rothman5/eighty-percent/README.md

# Mech-Eighty v1.0
A simple 87% mechanical keyboard for hobbyists. The system is implemented using an STM32 microcontroller.
This project was used to help me learn about microcontrollers, signal integrity and manufacturing.

## Features
- Uses my external [daughter board](https://github.com/rothman5/usbc-daughter-board) for USB.
- (TODO) QMK and VIA firmware support.
- (TODO) Gasket mount using poron foam gaskets.
- (TODO) Wooden, two-piece, CNC machined case.

## Photos
(TODO)

## References
- ST's [AN2586](https://www.st.com/resource/en/application_note/an2586-getting-started-with-stm32f10xxx-hardware-development-stmicroelectronics.pdf) hardware development article
- ST's [AN2867](https://www.st.com/resource/en/application_note/cd00221665-oscillator-design-guide-for-stm8afals-stm32-mcus-and-mpus-stmicroelectronics.pdf) oscillator design article
