rothman5/eighty-percent/images/keyboard-layout.png

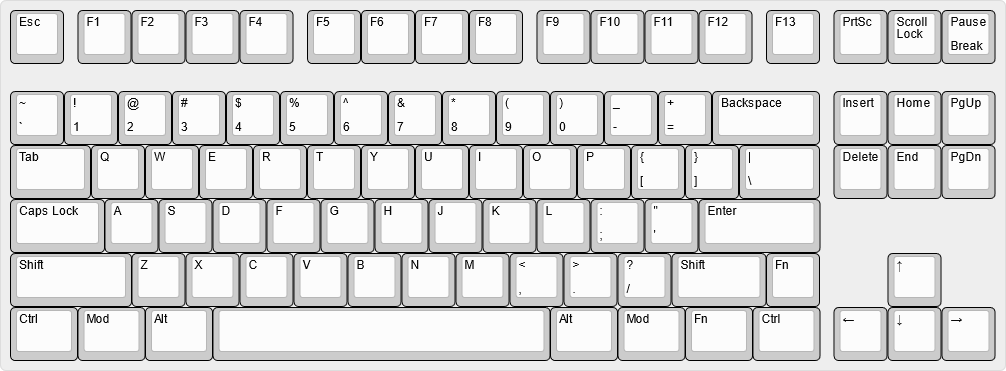
images/keyboard-layout.png
