rothman5/eighty-percent/images/pcb_back.pdf

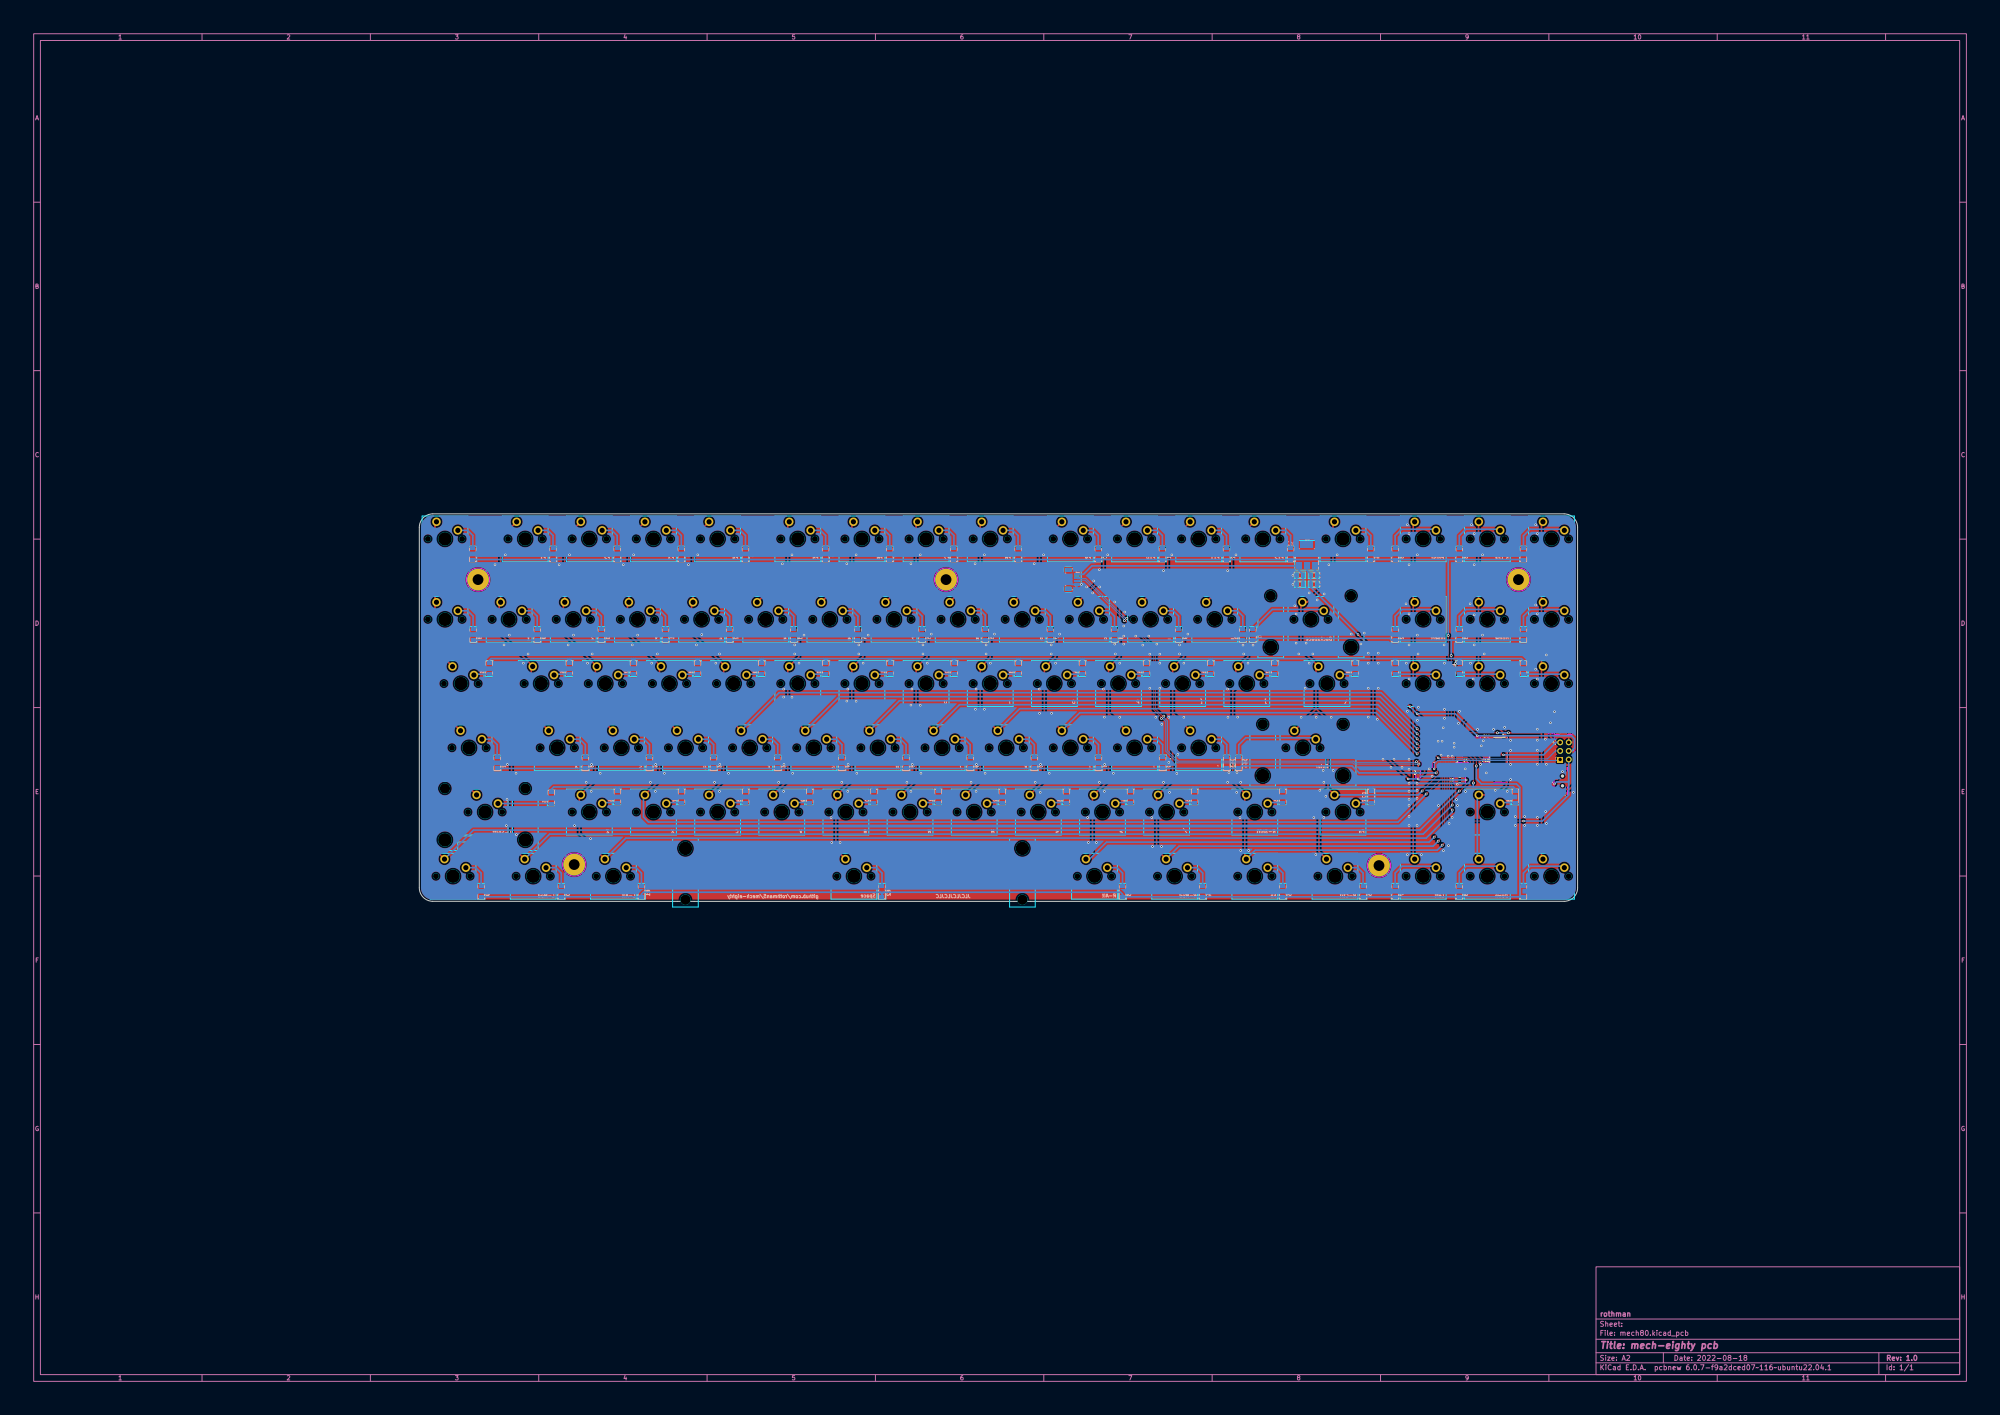
[picture p4: page 1]
