rothman5/eighty-percent/images/pcb_front.pdf

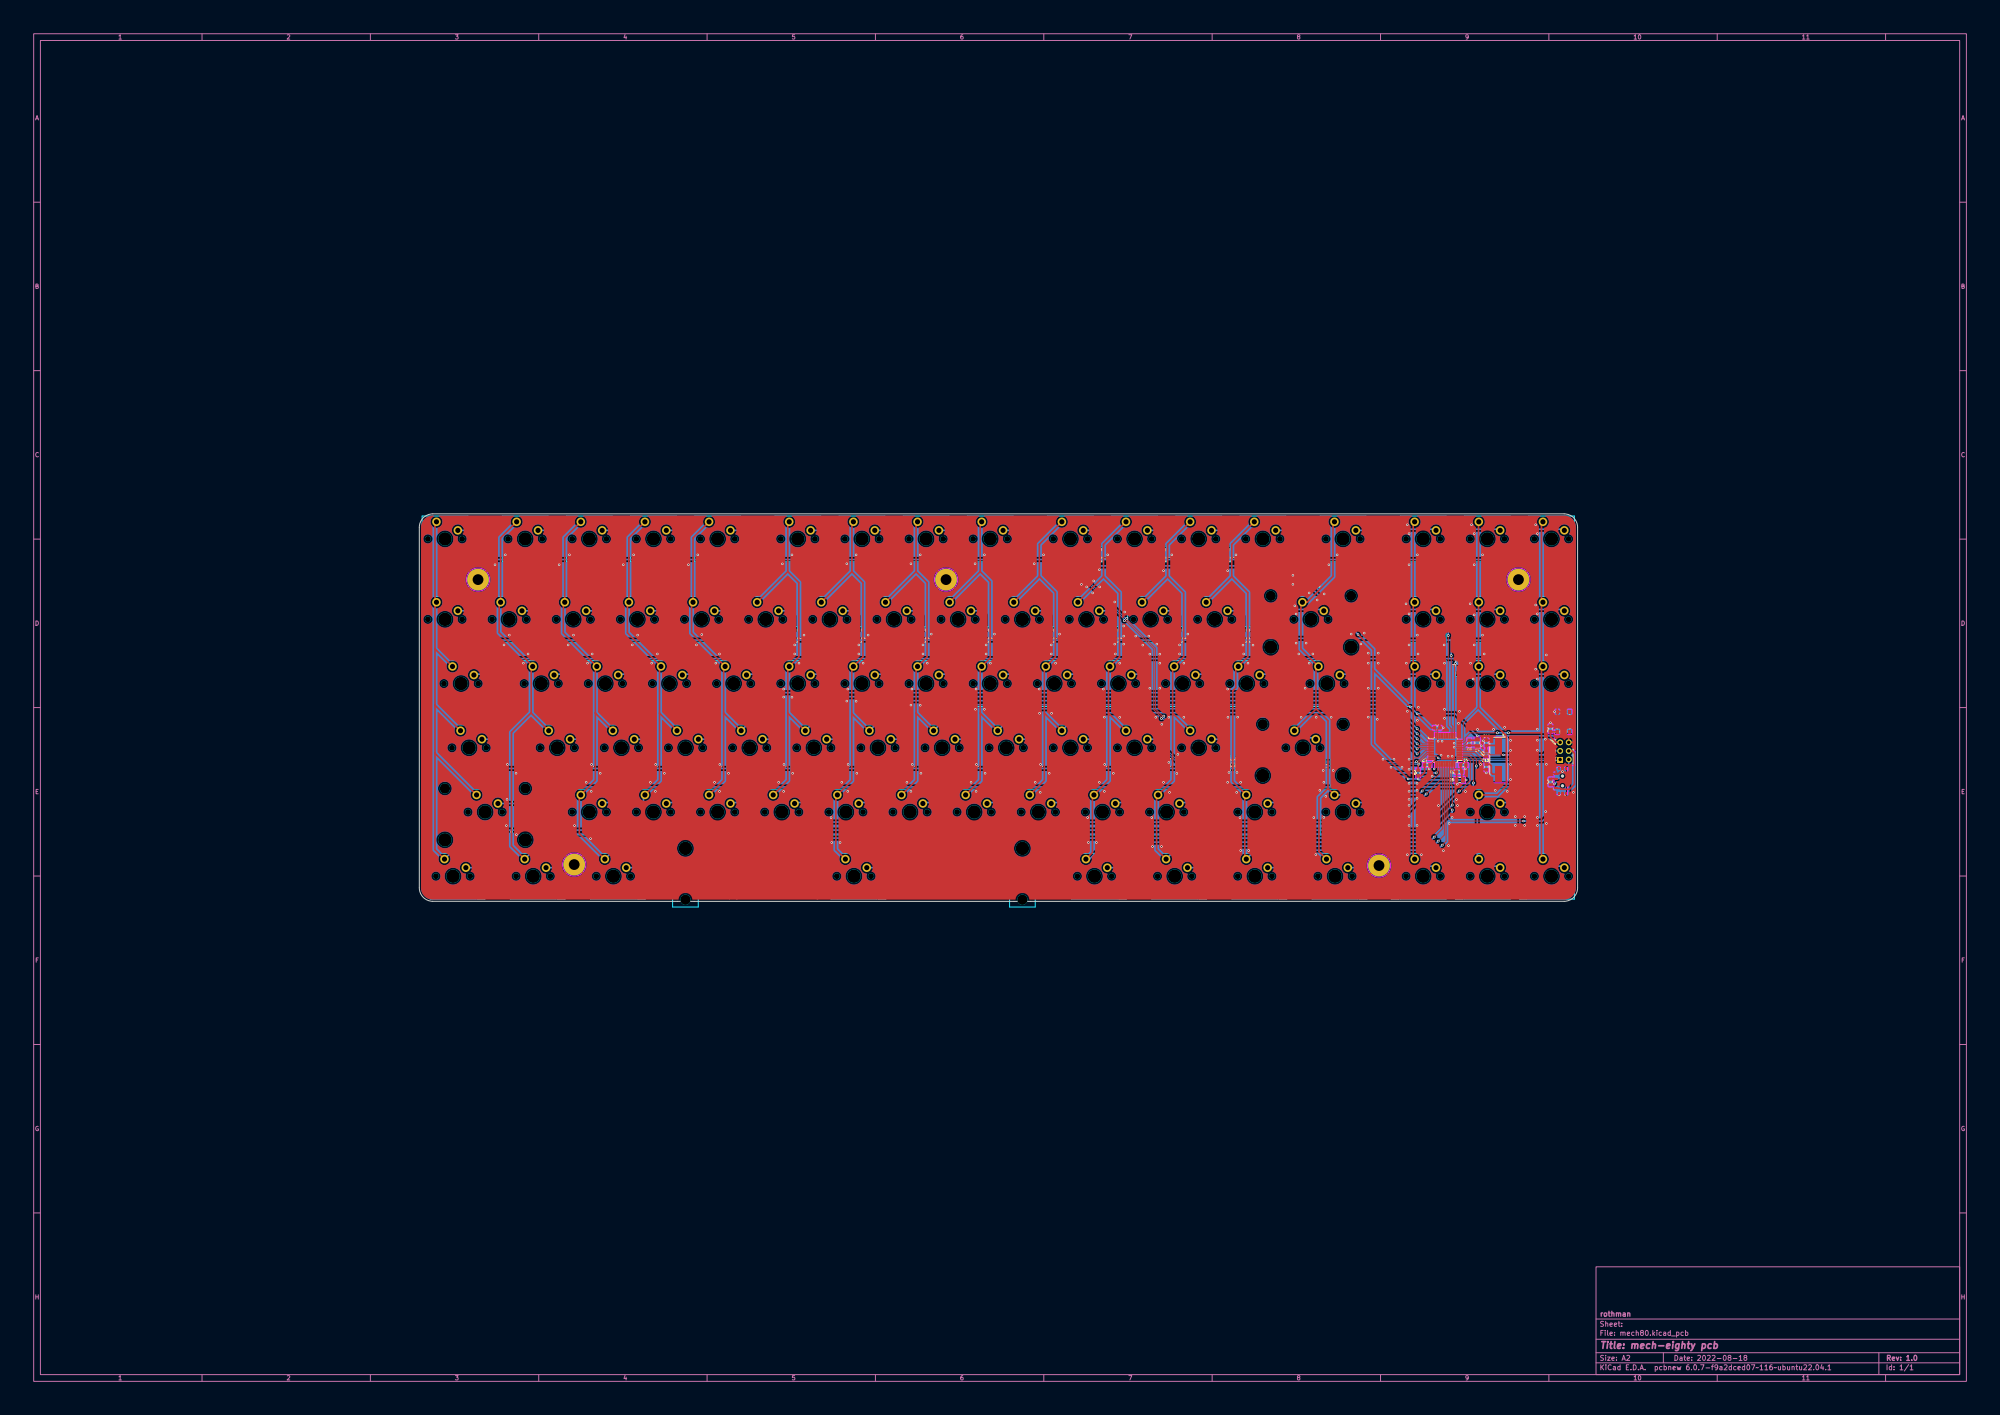
[picture p5: page 1]
