rothman5/eighty-percent/pcb/mech80.kicad_sch

## KiCad design pcb/mech80.kicad_sch (2022-08-21)

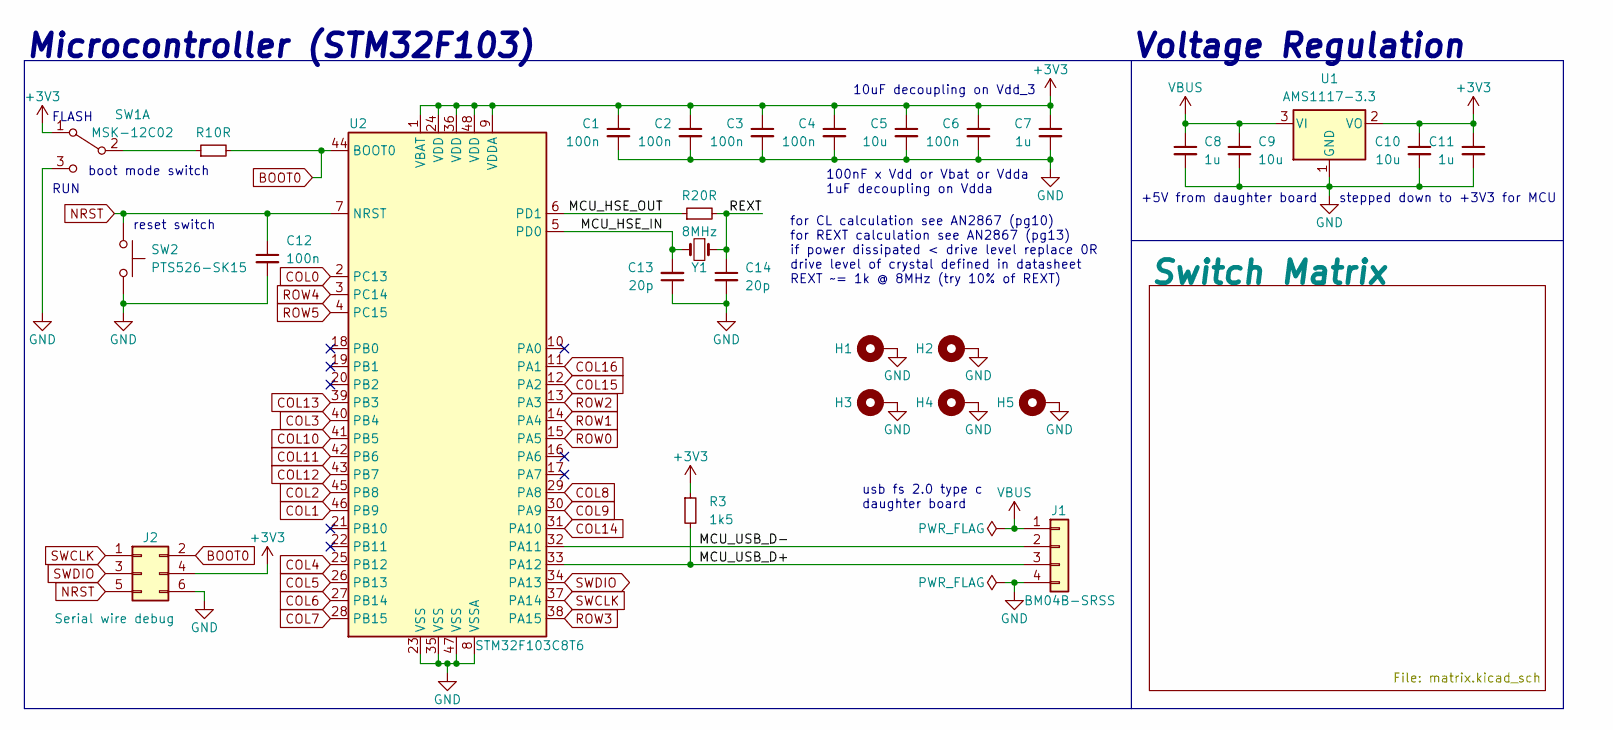
[picture p8: schematic mech80.kicad_sch]

Parts:
C1, C2, C3, C4, C6, C12: 100n; C_0603_1608Metric
C5, C9, C10: 10u; C_0805_2012Metric
C7, C8, C11: 1u; C_0805_2012Metric
C13, C14: 20p; C_0603_1608Metric
H1, H2, H3, H4, H5: MountingHole_Pad; MountingHole_3.2mm_M3_Pad
J1: BM04B-SRSS; JST_SH_BM04B-SRSS-TB_1x04-1MP_P1.00mm_Vertical
J2: Serial wire debug; PinSocket_2x03_P2.54mm_Vertical
R1, R2: 0R; R_0603_1608Metric
R3: 1k5; R_0603_1608Metric
SW1: MSK-12C02
SW2: PTS526-SK15; SW_PTS526_SM08_SMTR2_LFS
U1: AMS1117-3.3; SOT-223
U2: STM32F103C8T6; LQFP-48_7x7mm_P0.5mm
Y1: 8MHz; Crystal_SMD_HC49-SD

Connections:
+3V3: C1.1, C2.1, C3.1, C4.1, C5.1, C6.1, C7.1, C10.1, C11.1, J2.4, R3.1, SW1.1 (A), U1.2 (VO), U2.1 (VBAT), U2.9 (VDDA), U2.24 (VDD), U2.36 (VDD), U2.48 (VDD)
BOOT0: J2.2, R1.2, U2.44 (BOOT0)
COL0: U2.2 (PC13)
COL1: U2.46 (PB9)
COL2: U2.45 (PB8)
COL3: U2.40 (PB4)
COL4: U2.25 (PB12)
COL5: U2.26 (PB13)
COL6: U2.27 (PB14)
COL7: U2.28 (PB15)
COL8: U2.29 (PA8)
COL9: U2.30 (PA9)
COL10: U2.41 (PB5)
COL11: U2.42 (PB6)
COL12: U2.43 (PB7)
COL13: U2.39 (PB3)
COL14: U2.31 (PA10)
COL15: U2.12 (PA2)
COL16: U2.11 (PA1)
GND: C1.2, C2.2, C3.2, C4.2, C5.2, C6.2, C7.2, C8.2, C9.2, C10.2, C11.2, C12.2, C13.1, C14.2, H1.1, H2.1, H3.1, H4.1, H5.1, J1.4, J2.6, SW1.3 (C), SW2.2, U1.1 (GND), U2.8 (VSSA), U2.23 (VSS), U2.35 (VSS), U2.47 (VSS)
MCU_HSE_IN: C13.2, U2.5 (PD0), Y1.2
MCU_HSE_OUT: R2.1, U2.6 (PD1)
MCU_USB_D+: J1.3, R3.2, U2.33 (PA12)
MCU_USB_D-: J1.2, U2.32 (PA11)
NRST: C12.1, J2.5, SW2.1, U2.7 (NRST)
unnamed: R1.1, SW1.2 (B)
REXT: C14.1, R2.2, Y1.1
ROW0: U2.15 (PA5)
ROW1: U2.14 (PA4)
ROW2: U2.13 (PA3)
ROW3: U2.38 (PA15)
ROW4: U2.3 (PC14)
ROW5: U2.4 (PC15)
SWCLK: J2.1, U2.37 (PA14)
SWDIO: J2.3, U2.34 (PA13)
VBUS: C8.1, C9.1, J1.1, U1.3 (VI)

Notes on the sheet:
reset switch
+5V from daughter board
boot mode switch
Microcontroller (STM32F103)
100nF x Vdd or Vbat or Vdda 1uF decoupling on Vdda
Voltage Regulation
stepped down to +3V3 for MCU
10uF decoupling on Vdd_3
for CL calculation see AN2867 (pg10) for REXT calculation see AN2867 (pg13) if power dissipated < drive level replace 0R drive level of crystal defined in datasheet REXT ~= 1k @ 8MHz (try 10% of REXT)
usb fs 2.0 type c daughter board
RUN
FLASH
