rothman5/eighty-percent/(commit log)

2022-06-18 Added libraries, as well as created MCU schematic
    [mech-eighty.kicad_pcb, mech-eighty.kicad_sch]
2022-07-03 Schematic created
    [matrix.kicad_sch, mech-eighty.kicad_pcb, mech-eighty.kicad_sch]
2022-07-04 Schematic completed
    [matrix.kicad_sch, mech-eighty.kicad_sch]
2022-07-04 Routed matrix and MCU
    [matrix.kicad_sch, mech-eighty.kicad_sch]
2022-07-05 Routing completed
    [mech-eighty.kicad_sch]
2022-08-18 PCB layout complete
    [matrix.kicad_sch, mech-eighty.kicad_sch, mech80.kicad_sch]
2022-08-21 Custom footprints, symbols and 3dmodels added to project folder
2022-08-21 PCB has been wired completely and is ready for review before production
    [mech80.kicad_sch]
2022-08-21 Gerber files added in anticipation of order placement
